robogame-zrxz/docs-renewed/一审/一审时间和暑期课程安排.pdf

时间 | 内容 | 主讲人
7月17日 晚上19:30 | 机器人导论 | 董二宝
7月19日 下午15:00 | 焊接培训 | 张昊鹏、汪冰倩
7月19日 晚上19:30 | 电控基础知识 | 麻治昊
7月20日 晚上19:30 | 电控：通信协议 | 卢星宇
7月21日 晚上19:30 | 电控：控制算法（pid） | 麻治昊
7月22日 晚上19:30 | 电控：pcb设计 | 张昊鹏、胡宇凡
7月23日 晚上19:30 | 视觉：opencv基础 | 胡宇凡
7月24日 晚上19:30 | 视觉进阶：三维重建、信号分析处理 | 蒋宇航
7月25日 晚上19:30 | 视觉进阶：深度学习基础 | 蒋宇航

# 一审时间

7月31日 上午 9:00 开始，下午14:00开始，具体安排待后续公布

# 暑期课程安排
