robogame-zrxz/docs-renewed/计划书/robogame计划书/images/algo/dianji.png

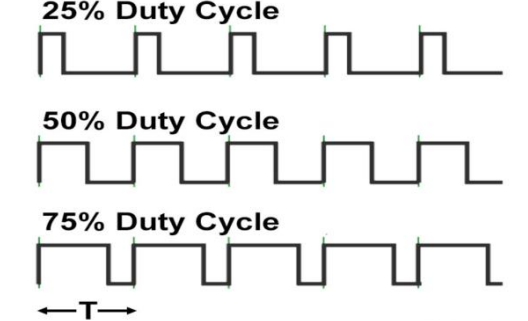
计划书/robogame计划书/images/algo/dianji.png
