robogame-zrxz/docs-renewed/计划书/robogame计划书/images/algo/way1.png

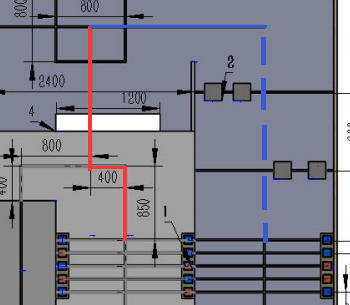
计划书/robogame计划书/images/algo/way1.png
