robogame-zrxz/docs-renewed/设计资料/红外阵列/PCB/BOM_红外阵列寻迹模块.csv

ID | Name | Designator | Footprint | Quantity | Manufacturer Part | Manufacturer | Supplier | Supplier Part | _Price | LCSC Assembly
1 | yellow | 51 | LED0603-R-RD | 1 | 19-213/Y2C-CQ2R2L/3T(CY) | EVERLIGHT | LCSC | C72038 | ￥0.118316 | Yes
2 | TCRT5000L | CGQ1,CGQ2,CGQ3,CGQ4,CGQ5,CGQ6,CGQ7,CGQ8 | OPTO-TH_TCRT5000L | 8 | TCRT5000L | VISHAY | LCSC | C24085 | ￥3.83
3 | 47uF | C3 | CAP-TH_BD5.0-P2.00-D0.8-FD | 1 | 47uF 16V Aluminum electrolytic capacitors | ValuePro | LCSC | C22320 | ￥0.050122
4 | 10nF | C2 | C0603 | 1 | 0603B103K500NT | FH | LCSC | C57112 | ￥0.019448 | Yes
5 | 10k | R2,R4,R6,R8,R10,R12,R14,R16,R10K,10K | R0805 | 10
6 | 200R | R1,R3,R5,R7,R9,R11,R13,R15 | R0805 | 8
7 | blue | PR | LED0603-R-RD | 1 | 19-217/BHC-ZL1M2RY/3T | EVERLIGHT | LCSC | C72041 | ￥0.088419 | Yes
8 | STC15W401AS-35I-TSSOP20 | U1 | TSSOP-20_L6.5-W4.4-P0.65-LS6.4-BL | 1 | STC15W401AS-35I-TSSOP20 | STC Micro | LCSC | C183052 | ￥3.06 | Yes
9 | UART | J1 | HDR-M-2.54_1X4 | 1 |  |  | LCSC | C124378 | ￥0.143949
10 | IIC3 | J2 | HDR-M-2.54_1X4 | 1 |  |  | LCSC | C124378 | ￥0.143949
11 | IIC1 | J3 | HDR-M-2.54_1X4 | 1 |  |  | LCSC | C124378 | ￥0.143949
12 | IIC2 | J4 | HDR-M-2.54_1X4 | 1 |  |  | LCSC | C124378 | ￥0.143949
