robogame-zrxz/docs-renewed/财务/机械采购清单.pdf

# 采购清单

### 1. 轴承

https://item.taobao.com/item.htm?spm=a1z0d.6639537/tb.1997196601.4.42c17484ABdy3y&id=606589201395 (https://item.taobao.com/item.htm?spm=a1z0d.6639537/tb.1997196601.4.42c17484ABdy3y&id=606589201395)

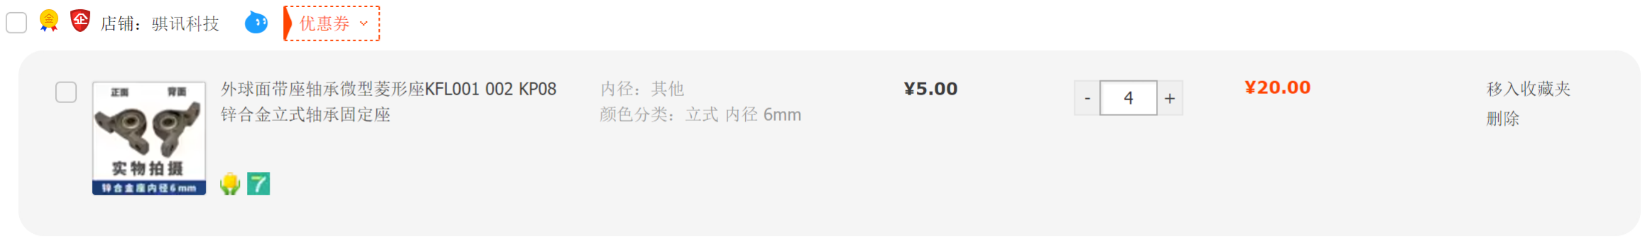
[picture p63: figure]

立式内径6mm 4个

### 2. 联轴器

https://item.taobao.com/item.htm?spm=a1z0d.6639537/tb.1997196601.56.42c17484ABdy3y&id=610200715175 (https://item.taobao.com/item.htm?spm=a1z0d.6639537/tb.1997196601.56.42c17484ABdy3y&id=610200715175)

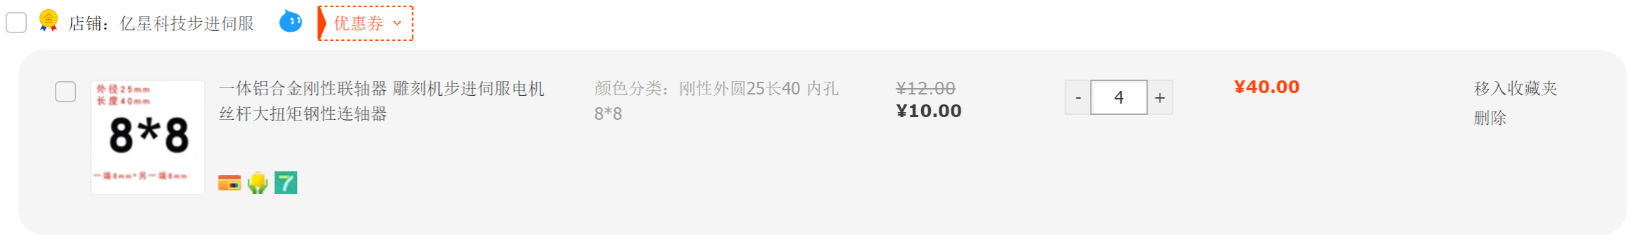
[picture p64: figure]

内孔8*8 4个

### 3. 立柱

https://detail.tmall.com/item.htm?id=670593678152&spm=a1z0d.6639537/t b.1997196601.38.42c17484ABdy3y (https://detail.tmall.com/item.htm?id=670593678152&spm=a1z0d.6639537/tb.1997196601.38.42c17484ABdy3y)

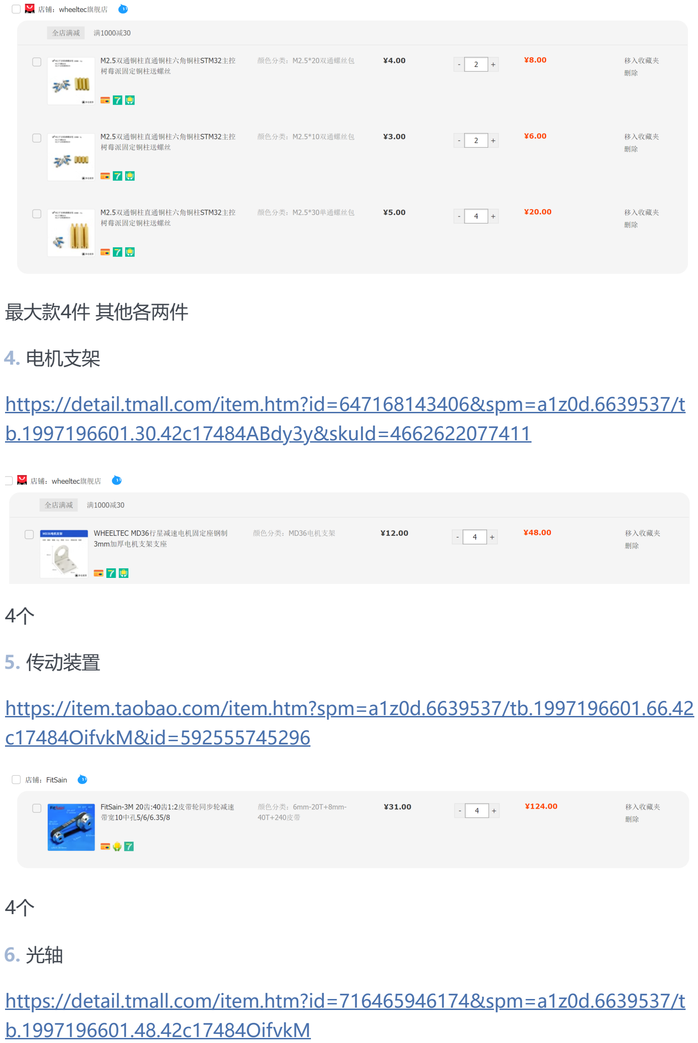
[picture p65: page 2]

最大款4件 其他各两件

### 4. 电机支架

https://detail.tmall.com/item.htm?id=647168143406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 (https://detail.tmall.com/item.htm?id=647168143406&skuId=4662622077411)

4个

### 5. 传动装置

https://item.taobao.com/item.htm?spm=a1z0d.6639537/tb.1997196601.66.42c17484OifvkM&id=592555745296 (https://item.taobao.com/item.htm?spm=a1z0d.6639537/tb.1997196601.66.42c17484OifvkM&id=592555745296)

4个

### 6. 光轴

https://detail.tmall.com/item.htm?id=716465946174&spm=a1z0d.6639537/t b.1997196601.48.42c17484OifvkM (https://detail.tmall.com/item.htm?id=716465946174&spm=a1z0d.6639537/tb.1997196601.48.42c17484OifvkM)

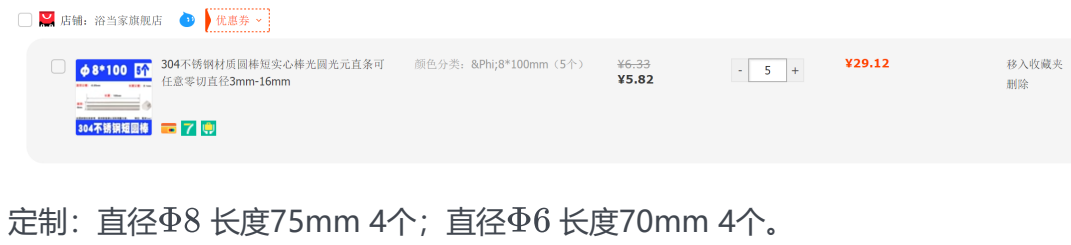
[picture p66: page 3]
