robogame-zrxz/docs-renewed/机械设计文件/设计/attempt1.SLDPRT

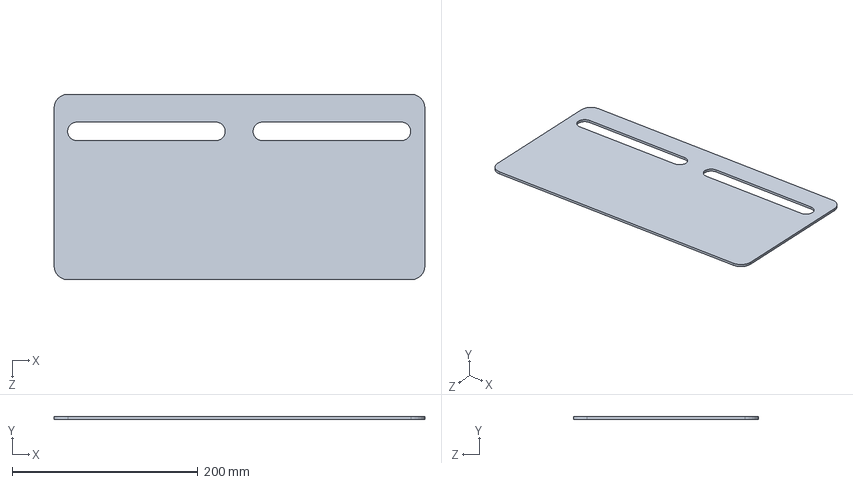
[picture p67: CAD file, 2023-08-26]
机械设计文件/设计/attempt1.SLDPRT
400.0 x 3.00 x 200.0 mm
