robogame-zrxz/docs-renewed/机械设计文件/设计/垫高/垫块35.SLDPRT

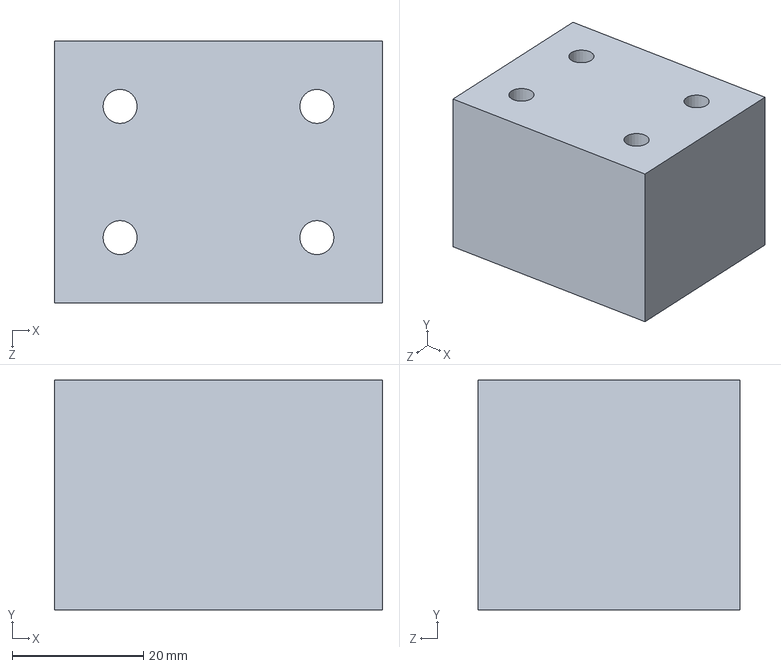
[picture p68: CAD file, 2023-09-04]
机械设计文件/设计/垫高/垫块35.SLDPRT
50.0 x 35.0 x 40.0 mm
