robogame-zrxz/docs-renewed/机械设计文件/设计/尾部胶轮/胶轮底盘.SLDPRT

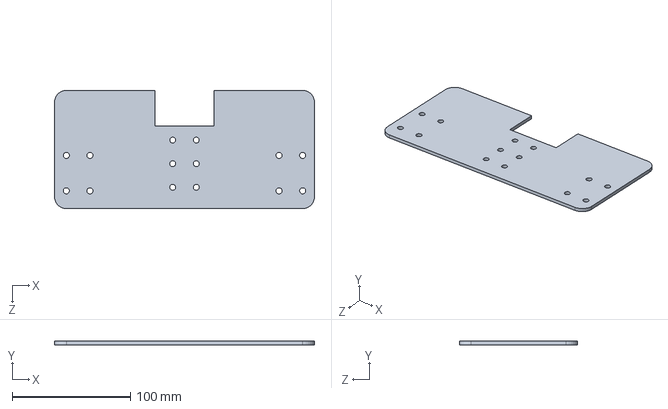
[picture p69: CAD file, 2023-08-26]
机械设计文件/设计/尾部胶轮/胶轮底盘.SLDPRT
220.0 x 3.00 x 100.0 mm
