robogame-zrxz/docs-renewed/机械设计文件/设计/底座/稳压模块底座.SLDPRT

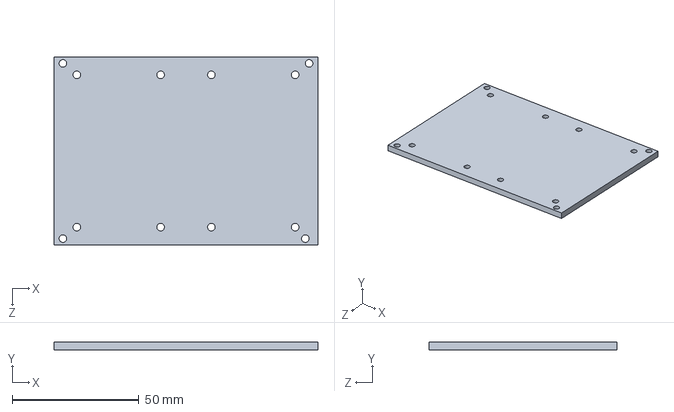
[picture p70: CAD file, 2023-08-26]
机械设计文件/设计/底座/稳压模块底座.SLDPRT
104.0 x 3.00 x 74.0 mm
