robogame-zrxz/docs-renewed/机械设计文件/设计/底盘/中部底盘-商家.STEP

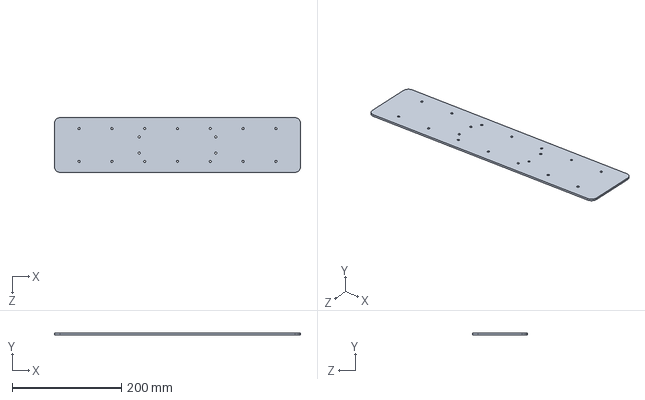
[picture p71: CAD file, 2023-08-26]
机械设计文件/设计/底盘/中部底盘-商家.STEP
450.0 x 3.00 x 100.0 mm
