robogame-zrxz/docs-renewed/机械设计文件/设计/垫高/电机垫高.SLDPRT

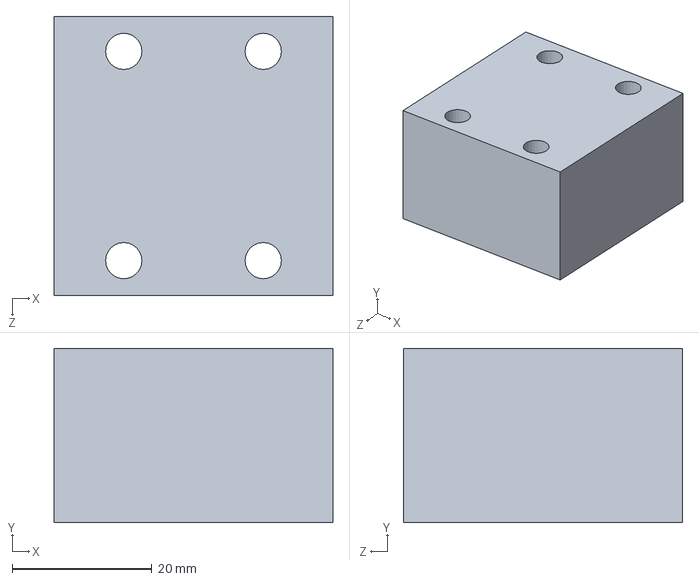
[picture p72: CAD file, 2023-08-26]
机械设计文件/设计/垫高/电机垫高.SLDPRT
40.0 x 25.0 x 40.0 mm
