robogame-zrxz/docs-renewed/机械设计文件/设计/底盘/底盘new.SLDPRT

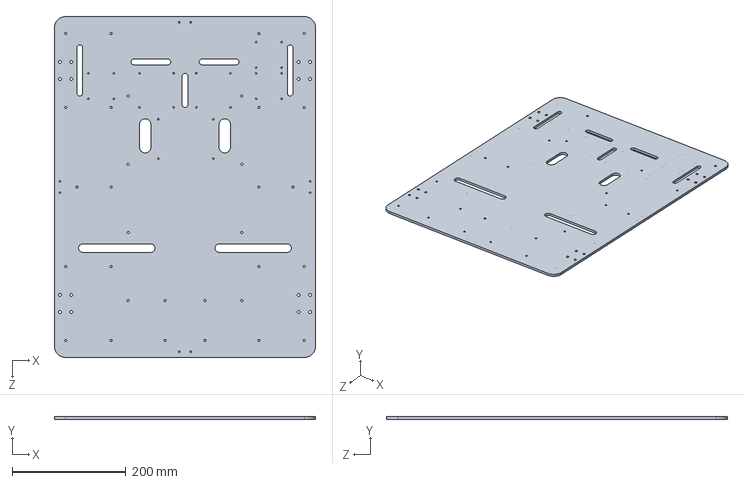
[picture p73: CAD file, 2023-08-26]
机械设计文件/设计/底盘/底盘new.SLDPRT
460.0 x 5.00 x 600.0 mm
