robogame-zrxz/docs-renewed/机械设计文件/设计/托盘.stl

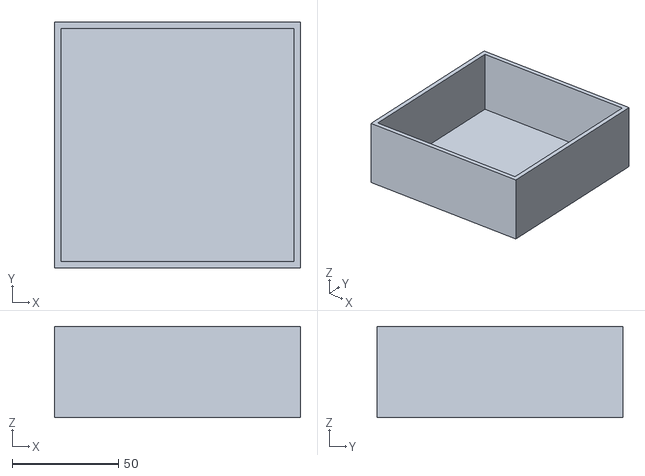
[picture p74: CAD file, 2023-08-26]
机械设计文件/设计/托盘.stl
116.0 x 116.0 x 43.0
