robogame-zrxz/docs-renewed/机械设计文件/设计/垫高/胶轮电机垫块.SLDPRT

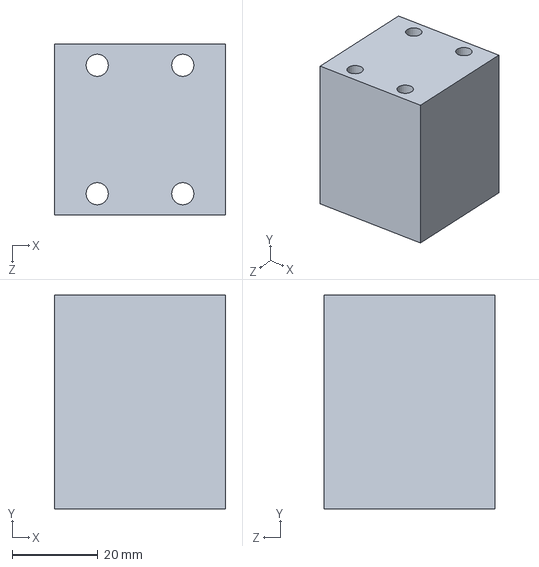
[picture p75: CAD file, 2023-08-26]
机械设计文件/设计/垫高/胶轮电机垫块.SLDPRT
40.0 x 50.0 x 40.0 mm
