robogame-zrxz/docs-renewed/机械设计文件/设计/底座/电机驱动模块底座.SLDPRT

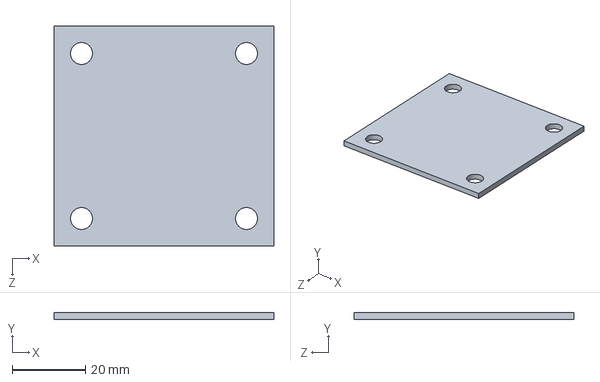
[picture p76: CAD file, 2023-08-26]
机械设计文件/设计/底座/电机驱动模块底座.SLDPRT
60.0 x 2.00 x 60.0 mm
