robogame-zrxz/docs-renewed/机械设计文件/设计/底盘/碳板底盘.SLDPRT

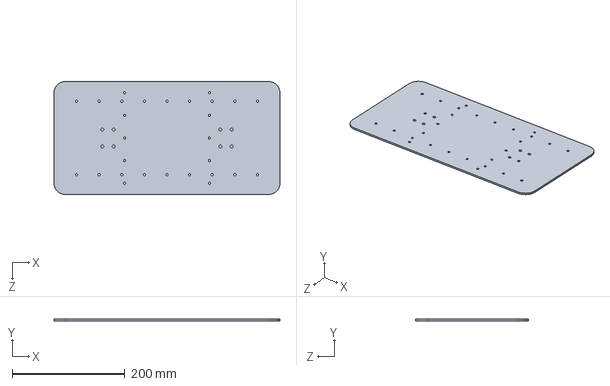
[picture p77: CAD file, 2023-08-26]
机械设计文件/设计/底盘/碳板底盘.SLDPRT
400.0 x 3.00 x 200.0 mm
