robogame-zrxz/docs-renewed/机械设计文件/设计/底座/分电板底座.SLDPRT

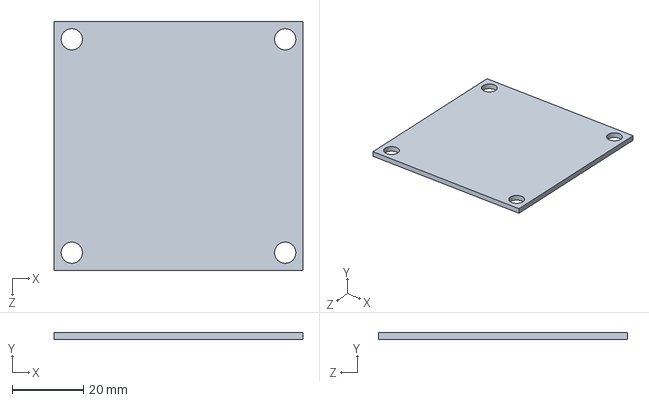
[picture p78: CAD file, 2023-08-26]
机械设计文件/设计/底座/分电板底座.SLDPRT
70.0 x 2.00 x 70.0 mm
