robogame-zrxz/docs-renewed/机械设计文件/设计/底座/stm底座.SLDPRT

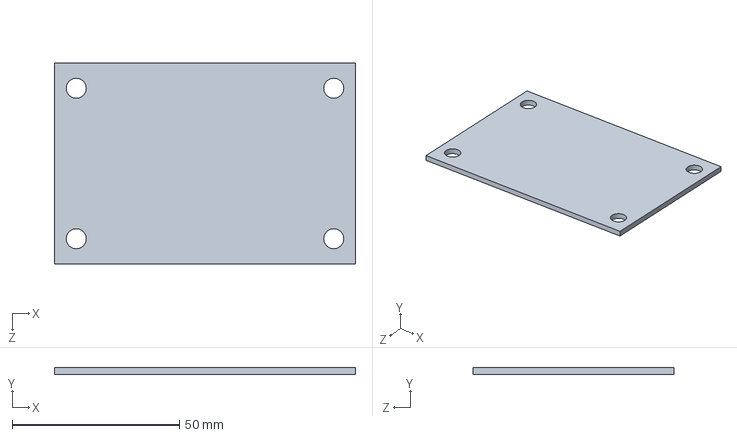
[picture p79: CAD file, 2023-08-26]
机械设计文件/设计/底座/stm底座.SLDPRT
90.0 x 2.00 x 60.0 mm
