robogame-zrxz/docs-renewed/机械设计文件/设计/底座/stm底座 要一个.DXF

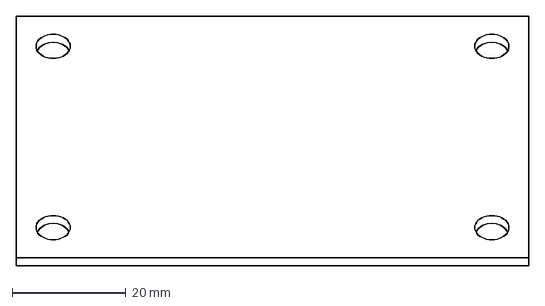
[picture p80: CAD file, 2023-08-26]
机械设计文件/设计/底座/stm底座 要一个.DXF
90.0 x 43.8 mm
