robogame-zrxz/docs-renewed/机械设计文件/设计/底座/分电板底座 要一个.DXF

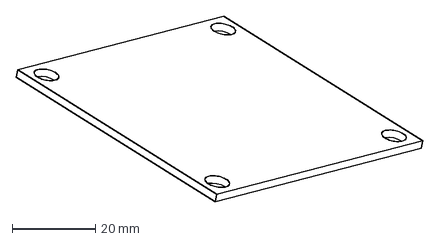
[picture p81: CAD file, 2023-08-26]
机械设计文件/设计/底座/分电板底座 要一个.DXF
97.7 x 44.5 mm
