robogame-zrxz/docs-renewed/机械设计文件/设计/底座/电机驱动模块底座 要两个.DXF

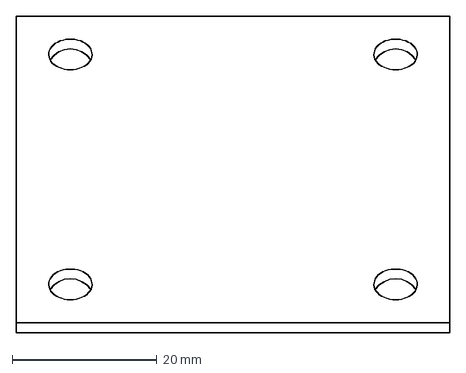
[picture p82: CAD file, 2023-08-26]
机械设计文件/设计/底座/电机驱动模块底座 要两个.DXF
60.0 x 43.8 mm
