robogame-zrxz/docs-renewed/(list of files, cad)

Other CAD files:
设计资料/红外阵列/Project_STC15W401AS/main.OBJ
机械设计文件/设计/底座/稳压模块底座-cad.DWG
设计资料/红外阵列/Project_STC15W401AS/8路灰度传感器.OBJ
设计资料/红外阵列/Project_STC15W401AS/I2C.OBJ
机械设计文件/设计/底盘/头尾底盘.SLDPRT
机械设计文件/设计/底盘/头尾底盘-商家.STEP
机械设计文件/设计/底盘/中部底盘.SLDPRT
机械设计文件/设计/垫高/垫块35.STL
机械设计文件/设计/垫高/电机垫高.STL
机械设计文件/设计/垫高/胶轮电机垫块.STL
机械设计文件/设计/尾部胶轮/丝杆固定yy.SLDDRW
机械设计文件/设计/尾部胶轮/胶轮底盘.DWG
机械设计文件/设计/底座/分电板底座.DXF
机械设计文件/设计/底盘/底盘new.DWG
