robogame-zrxz/docs-renewed/设计资料/红外阵列/PCB/Schematic_红外阵列寻迹模块.pdf

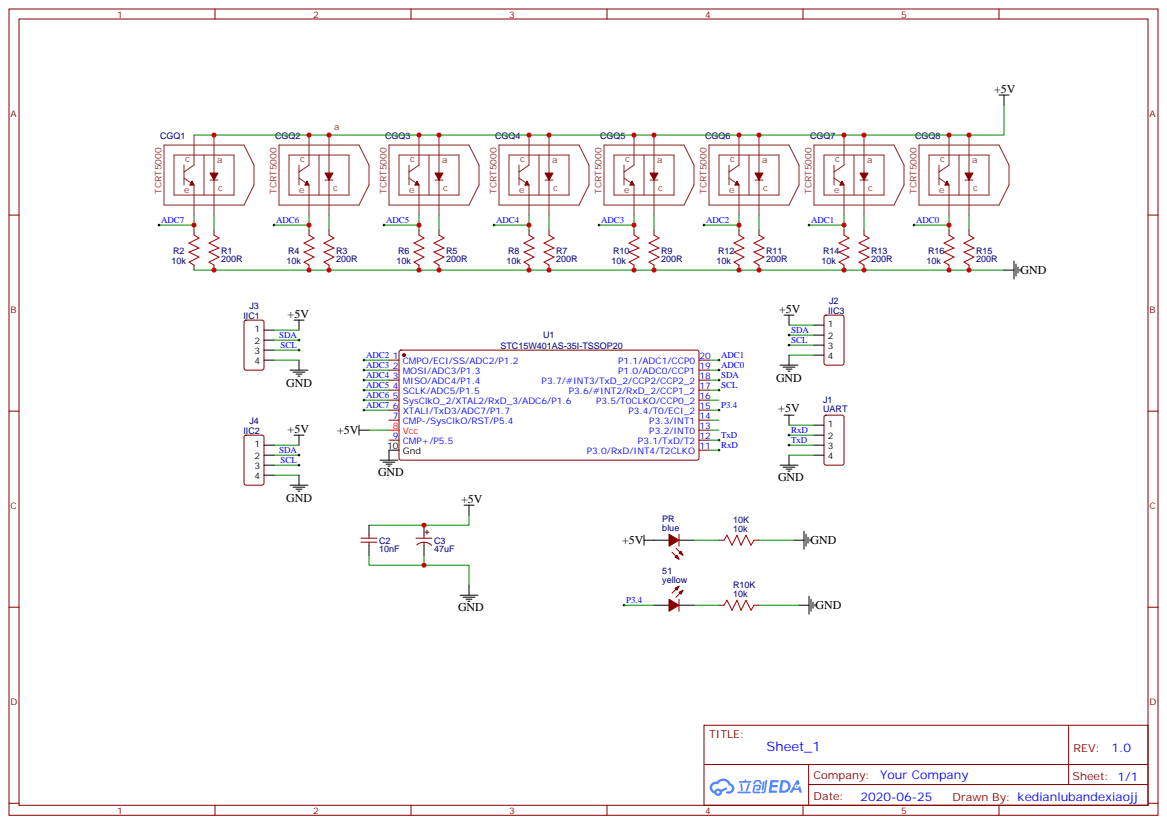
[picture p83: page 1]
