robogame-zrxz/docs-renewed/计划书/robogame计划书/images/algo/main_flow.pdf

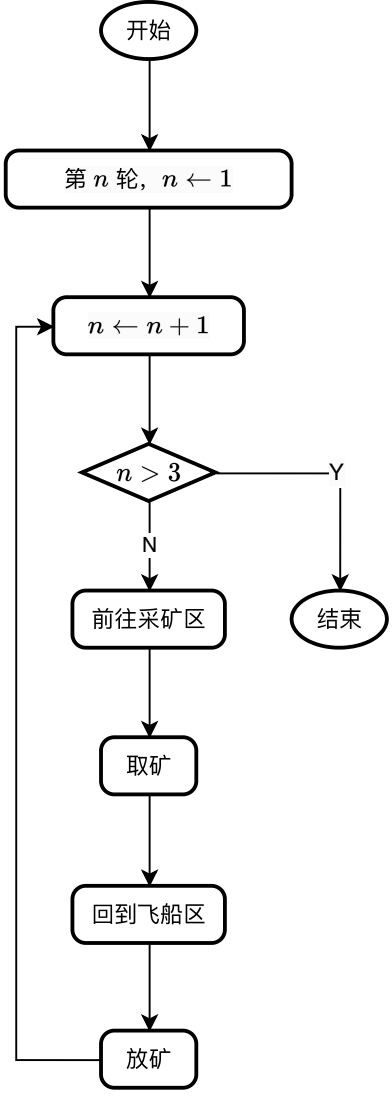
[picture p93: page 1]
前往采矿区; 回到飞船区
