robogame-zrxz/docs-renewed/计划书/robogame计划书/images/algo/mining.pdf

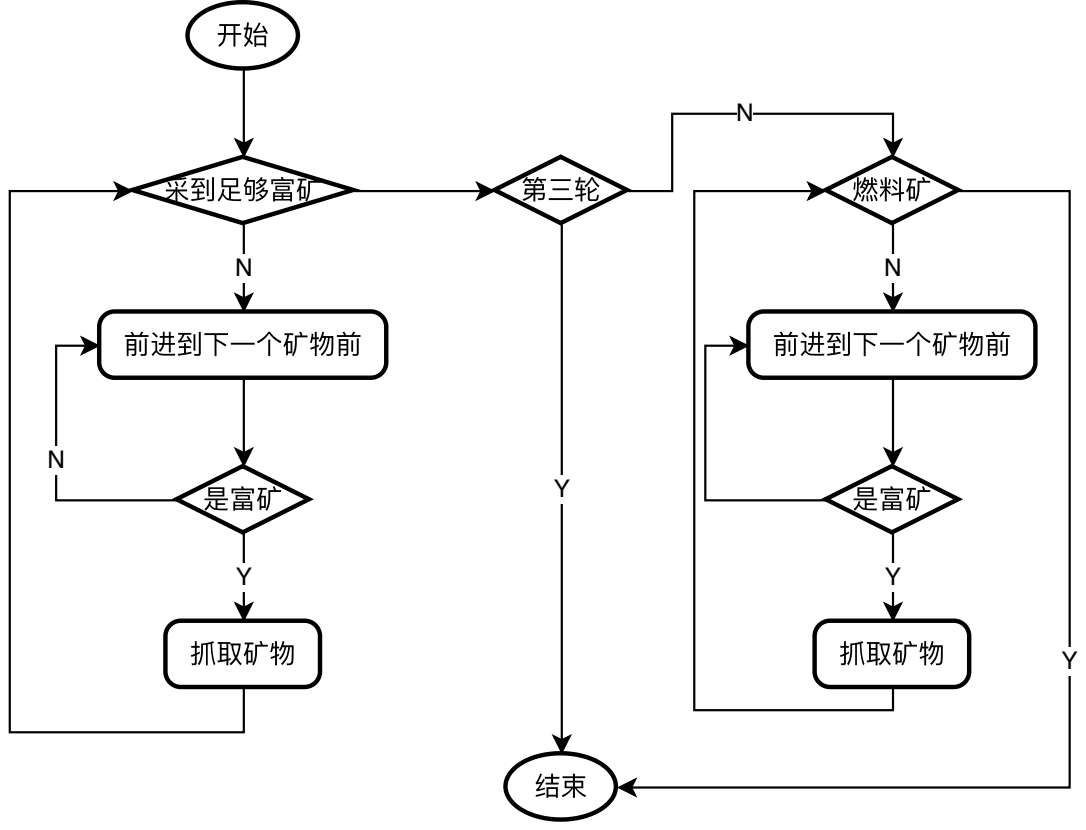
[picture p94: page 1]
采到足够富矿; 前进到下一个矿物前; 是富矿; 抓取矿物; 第三轮; 燃料矿
