robogame-zrxz/docs-renewed/(list of files, drawings)

Other design files:
设计资料/红外阵列/PCB/PCB_PCB红外阵列.json
